smily77/ForEx/README.md

Desktop Widget displaying:
- Time
- Date
- Actual Time of 6 locations
- Foreign Exchange rates for 3 currencies
