smily77/ForEx/STL/DesktopWidget_II_cover.stl

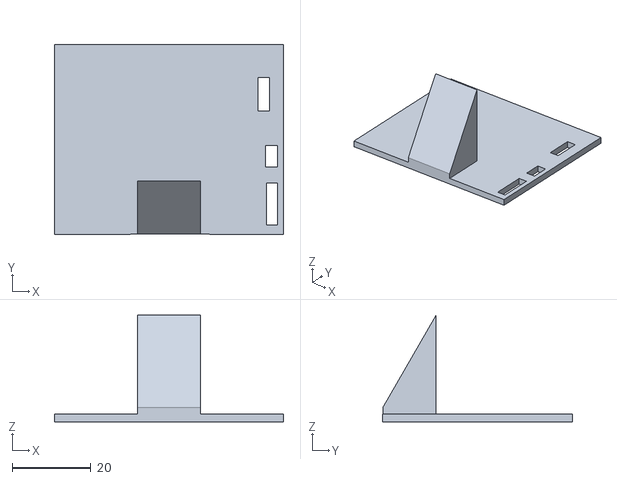
[picture p1: CAD file, 2016-04-16]
STL/DesktopWidget_II_cover.stl
58.0 x 48.0 x 27.0
