smily77/ForEx/STL/DesktopWidget_II_body.stl

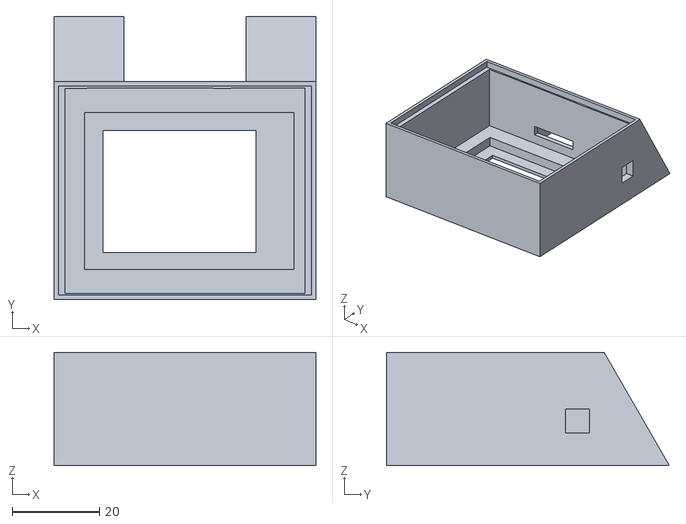
[picture p2: CAD file, 2016-04-16]
STL/DesktopWidget_II_body.stl
60.0 x 64.9 x 26.0
