smily77/ForEx/STL/DesktopWidget_II_knob.stl

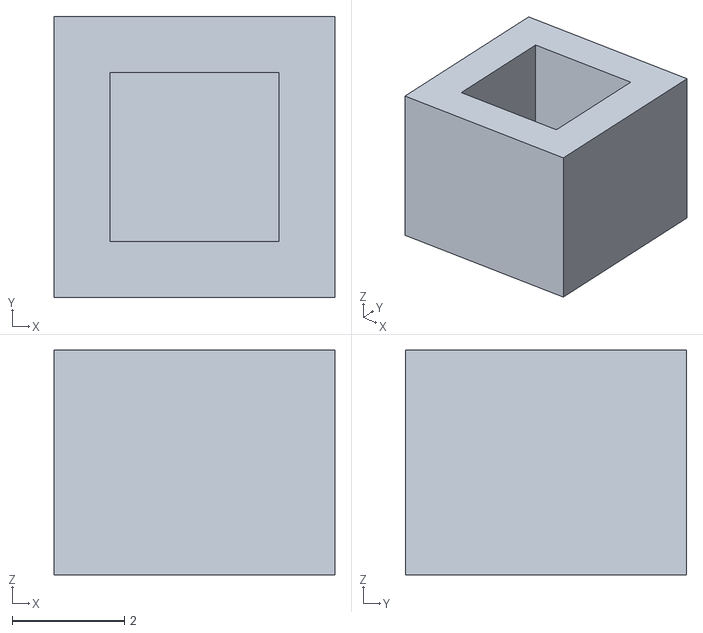
[picture p3: CAD file, 2016-04-16]
STL/DesktopWidget_II_knob.stl
5.00 x 5.00 x 4.00
