smily77/ForEx/Cirquit/Forex_cirquit.pdf

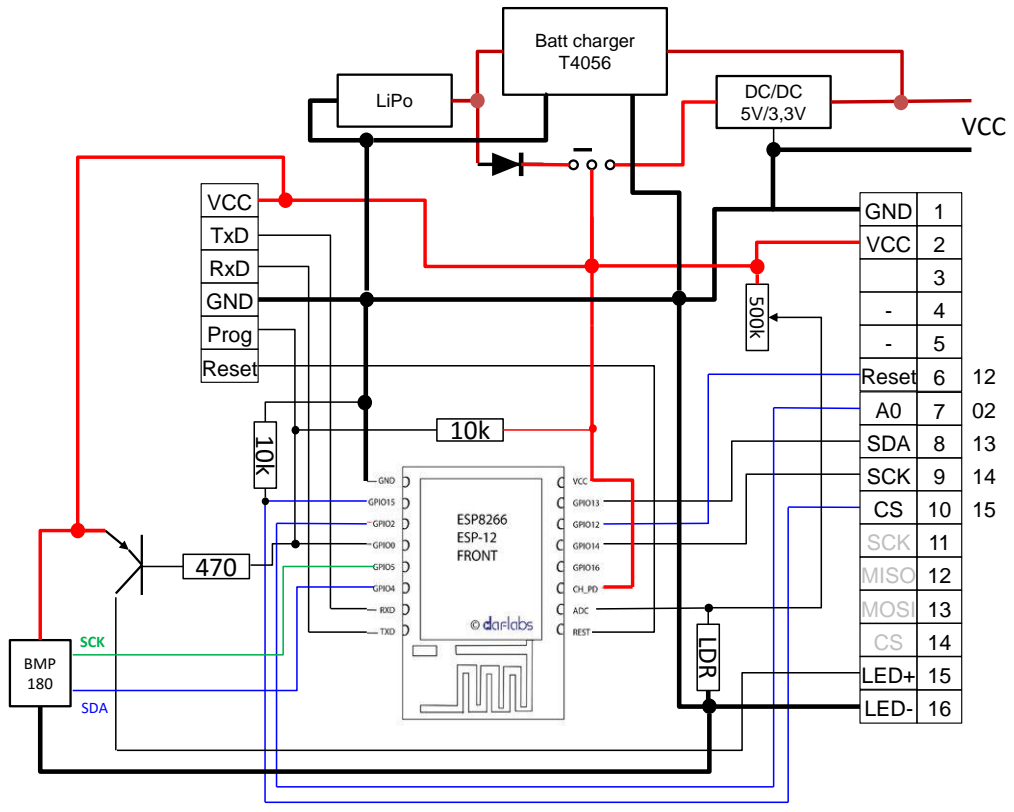
[picture p4: page 1]
VCC; TxD; GND; RxD; Prog; Reset; GND VCC--; SDA; SCK; MISO; MOSI; LED+; LED; LiPo; Batt charger T4056; LDR; BMP 180
