smily77/ForEx/ForEx_2_UART_Frankfurter/X_InternetInfo.ino

// X_InternetInfo.ino – ForEx_2_1_Frankfurter
// Wechselkurse per LTE-Modul BK-7670 abrufen.
//
// ARCHITEKTUR (v2.1-FR-SSL):
//   Statt den eingebauten HTTP/SSL-Stack des BK-7670 zu nutzen (dessen
//   TLS-Fingerprint von Cloudflare blockiert wird), öffnet das Modul nur
//   eine rohe TCP-Verbindung.  BearSSL auf dem ESP8266 übernimmt den
//   TLS-Handshake – mit demselben JA3-Fingerprint wie beim 4G-Modem/WiFi.
//
//   LTEClient  (AT+CIPOPEN, TCP-Transport)
//       ↓
//   ESP_SSLClient  (BearSSL TLS, läuft auf ESP8266)
//       ↓
//   api.frankfurter.app:443  (Cloudflare akzeptiert BearSSL-JA3)
//
// ABHÄNGIGKEIT:
//   Bibliothek "ESP_SSLClient" von mobizt installieren:
//     Arduino IDE: Sketch → Bibliothek einbinden → Bibliotheken verwalten
//                  → "ESP_SSLClient" suchen und installieren
//     PlatformIO:  lib_deps = mobizt/ESP_SSLClient
//
// ESP8266 SDK – CPU-Frequenz umschalten (80 ↔ 160 MHz)
extern "C" {
  #include "user_interface.h"
}

// ============================================================
// LTEClient – Arduino-Client-Adapter für BK-7670 (SIMCom A7670E)
//
// Stellt eine rohe TCP-Verbindung über die AT-Befehle des Moduls her.
// Implementiert das Arduino-Client-Interface, damit ESP_SSLClient
// (BearSSL) darauf aufsetzen kann.
//
// WICHTIG: Alle Methoden die von BearSSL im TLS-Handshake aufgerufen
// werden (write/available/read) verwenden statische char-Puffer statt
// String-Objekte, um Heap-Fragmentierung zu vermeiden.
// BearSSL ruft available() hunderte Male auf – jede String-Allokation
// dort würde den Heap nach wenigen Handshakes zerstören.
//
// AT-Befehlssatz: NETOPEN / CIPOPEN / CIPSEND / CIPRXGET / CIPCLOSE
// Referenz: A76XX Series TCPIP Application Note (SIMCom)
// ============================================================
class LTEClient : public Client {
public:

  // --- Verbindung aufbauen ---
  // KEINE String-Allokation! connect() läuft direkt vor dem TLS-Handshake.
  // Jede String-Allokation hier fragmentiert den Heap und kann dazu führen,
  // dass BearSSL's malloc() NULL zurückgibt → Exception (28).
  int connect(const char *host, uint16_t port) override {
    _connected = false;
    _rxLen = 0;
    _rxPos = 0;
    _lastPoll = 0;

    // Alle AT-Befehle mit statischen Puffern – kein String/Heap
    _sendATraw(F("AT+CIPRXGET=1"), 2000);
    _sendATraw(F("AT+CIPCLOSE=0"), 2000);
    _sendATraw(F("AT+NETCLOSE"), 5000);
    delay(500);

    _sendATraw(F("AT+CSOCKSETPN=1"), 1000);
    _sendATraw(F("AT+CIPMODE=0"), 1000);

    _sendATraw(F("AT+NETOPEN"), 15000);
    delay(1000);

    // TCP-Verbindung öffnen (einziger dynamischer Befehl → _sendATcmd)
    char cmd[80];
    snprintf(cmd, sizeof(cmd),
             "AT+CIPOPEN=0,\"TCP\",\"%s\",%d", host, port);
    _sendATcmd(cmd, 20000, "+CIPOPEN: 0,0");

    if (strstr(_atBuf, "+CIPOPEN: 0,0") != NULL) {
      _connected = true;
      return 1;
    }
    return 0;
  }

  int connect(IPAddress ip, uint16_t port) override {
    char host[16];
    snprintf(host, sizeof(host), "%d.%d.%d.%d", ip[0], ip[1], ip[2], ip[3]);
    return connect(host, port);
  }

  // --- Daten senden ---
  // HOT PATH: wird von BearSSL während TLS-Handshake aufgerufen.
  // Verwendet statische Puffer statt String.
  size_t write(uint8_t b) override { return write(&b, 1); }

  size_t write(const uint8_t *buf, size_t size) override {
    if (!_connected || size == 0) return 0;

    // A7670 CIPSEND max 1460 Bytes pro Aufruf (ein TCP-Segment)
    int toSend = (size > 1024) ? 1024 : (int)size;

    char cmd[32];
    snprintf(cmd, sizeof(cmd), "AT+CIPSEND=0,%d", toSend);

    // AT-Befehl senden, auf ">" Prompt warten
    delay(10);  // 10ms reicht – Modul verarbeitet CIPSEND schnell
    while (lteSerial.available()) lteSerial.read();
    lteSerial.println(cmd);

    bool gotPrompt = false;
    unsigned long t0 = millis();
    while (millis() - t0 < 5000) {
      while (lteSerial.available()) {
        if (lteSerial.read() == '>') { gotPrompt = true; break; }
      }
      if (gotPrompt) break;
      ESP.wdtFeed();
      yield();
    }
    if (!gotPrompt) { _connected = false; return 0; }

    // Restliche Zeichen nach ">" konsumieren
    delay(10);
    while (lteSerial.available()) lteSerial.read();

    // Binärdaten senden als Block-Write.
    lteSerial.write(buf, toSend);

    // +CIPSEND Bestätigung abwarten – statischer Puffer statt String
    int rLen = 0;
    t0 = millis();
    while (millis() - t0 < 10000 && rLen < (int)sizeof(_atBuf) - 1) {
      while (lteSerial.available() && rLen < (int)sizeof(_atBuf) - 1) {
        _atBuf[rLen++] = (char)lteSerial.read();
      }
      _atBuf[rLen] = '\0';
      if (strstr(_atBuf, "+CIPSEND:") != NULL) break;
      if (strstr(_atBuf, "ERROR") != NULL) { _connected = false; return 0; }
      ESP.wdtFeed();
      yield();
    }
    return toSend;
  }

  // --- Daten empfangen ---
  // HOT PATH: BearSSL pollt available() intensiv während TLS.
  // Komplett ohne String/Heap-Allokation implementiert.
  int available() override {
    if (_rxPos < _rxLen) return _rxLen - _rxPos;

    // Modul nicht öfter als alle 20 ms abfragen (BearSSL pollt intensiv).
    // 20ms statt 50ms: schnellere Handshake-Antwortzeiten, bei 19200 Baud
    // ist eine AT-Antwort (~30 Bytes) in ~15ms komplett übertragen.
    unsigned long now = millis();
    if (now - _lastPoll < 20) return 0;
    _lastPoll = now;

    // Modul nach gepufferten Bytes fragen – statischer Puffer
    _sendATraw(F("AT+CIPRXGET=4,0"), 1000);

    char* idx = strstr(_atBuf, "+CIPRXGET: 4,0,");
    if (idx) {
      int avail = atoi(idx + 15);
      if (avail > 0) {
        _pullFromModule(avail);
        return _rxLen - _rxPos;
      }
    }
    return 0;
  }

  int read() override {
    uint8_t b;
    if (read(&b, 1) == 1) return b;
    return -1;
  }

  // HOT PATH: Verwendet statischen Puffer für AT-Abfrage
  int read(uint8_t *buf, size_t size) override {
    // Aus lokalem Puffer bedienen
    if (_rxPos < _rxLen) {
      int avail = _rxLen - _rxPos;
      int n = ((int)size < avail) ? (int)size : avail;
      memcpy(buf, _rxBuf + _rxPos, n);
      _rxPos += n;
      return n;
    }

    // Puffer leer → vom Modul nachladen (statischer Puffer)
    _sendATraw(F("AT+CIPRXGET=4,0"), 1000);

    char* idx = strstr(_atBuf, "+CIPRXGET: 4,0,");
    if (!idx) return 0;
    int moduleAvail = atoi(idx + 15);
    if (moduleAvail <= 0) return 0;

    _pullFromModule(moduleAvail);

    if (_rxLen <= 0) return 0;
    int n = ((int)size < _rxLen) ? (int)size : _rxLen;
    memcpy(buf, _rxBuf, n);
    _rxPos = n;
    return n;
  }

  int peek() override {
    if (_rxPos < _rxLen) return _rxBuf[_rxPos];
    return -1;
  }

  void flush() override { }

  void stop() override {
    _sendATraw(F("AT+CIPCLOSE=0"), 5000);
    delay(500);
    _sendATraw(F("AT+NETCLOSE"), 5000);
    _connected = false;
    _rxLen = 0;
    _rxPos = 0;
  }

  uint8_t connected() override { return _connected ? 1 : 0; }
  operator bool() override { return _connected; }

private:
  bool _connected = false;
  static uint8_t _rxBuf[256];   // Statischer Empfangspuffer (spart Stack)
  int _rxLen = 0;               // Gültige Bytes im Puffer
  int _rxPos = 0;               // Aktuelle Leseposition
  unsigned long _lastPoll = 0;  // Letzte Modul-Abfrage (Throttle)

  // Statischer AT-Antwortpuffer – wird von allen Methoden geteilt.
  // 128 Bytes: genug für CIPOPEN-Echo (~55 Bytes) + Antwort.
  // Kein Reentrancy-Problem da ESP8266 single-threaded ist.
  static char _atBuf[128];

  // AT-Befehl senden (F-String) und Antwort in _atBuf lesen.
  // Wartet auf "OK" oder "ERROR". KEINE Heap-Allokation.
  void _sendATraw(const __FlashStringHelper* cmd, unsigned long timeout) {
    int len = 0;
    delay(10);
    while (lteSerial.available()) lteSerial.read();
    lteSerial.println(cmd);

    unsigned long t0 = millis();
    while (millis() - t0 < timeout && len < (int)sizeof(_atBuf) - 1) {
      while (lteSerial.available() && len < (int)sizeof(_atBuf) - 1) {
        _atBuf[len++] = (char)lteSerial.read();
      }
      _atBuf[len] = '\0';
      if (strstr(_atBuf, "OK\r") || strstr(_atBuf, "ERROR")) break;
      ESP.wdtFeed();
      yield();
    }
    _atBuf[len] = '\0';
  }

  // AT-Befehl senden (C-String) mit optionalem waitFor-Keyword.
  // Für connect()/stop() – dynamische Befehle wie AT+CIPOPEN.
  void _sendATcmd(const char* cmd, unsigned long timeout, const char* waitFor = nullptr) {
    int len = 0;
    delay(10);
    while (lteSerial.available()) lteSerial.read();
    lteSerial.println(cmd);

    unsigned long t0 = millis();
    while (millis() - t0 < timeout && len < (int)sizeof(_atBuf) - 1) {
      while (lteSerial.available() && len < (int)sizeof(_atBuf) - 1) {
        _atBuf[len++] = (char)lteSerial.read();
      }
      _atBuf[len] = '\0';
      if (waitFor) {
        if (strstr(_atBuf, waitFor)) break;
      } else {
        if (strstr(_atBuf, "OK\r")) break;
      }
      if (strstr(_atBuf, "ERROR")) break;
      ESP.wdtFeed();
      yield();
    }
    _atBuf[len] = '\0';
  }

  // Daten vom Modul in den lokalen Puffer lesen.
  // AT+CIPRXGET=2,0,<len> → +CIPRXGET: 2,0,<actual>,<remaining>\r\n<Daten>\r\nOK
  // Verwendet statischen Header-Puffer statt String.
  void _pullFromModule(int moduleAvail) {
    _rxLen = 0;
    _rxPos = 0;

    int toRead = moduleAvail;
    if (toRead > (int)sizeof(_rxBuf)) toRead = (int)sizeof(_rxBuf);

    char cmd[32];
    snprintf(cmd, sizeof(cmd), "AT+CIPRXGET=2,0,%d", toRead);

    delay(10);  // 10ms reicht für CIPRXGET=2 (statt 30ms)
    while (lteSerial.available()) lteSerial.read();
    lteSerial.println(cmd);

    // Header lesen: +CIPRXGET: 2,0,<actual>,<remaining>\r\n
    // Statischer Puffer statt String – kein Heap-Allokation
    static char hdr[80];
    int hdrLen = 0;
    bool gotHeader = false;
    unsigned long t0 = millis();
    while (millis() - t0 < 5000 && hdrLen < (int)sizeof(hdr) - 1) {
      while (lteSerial.available() && hdrLen < (int)sizeof(hdr) - 1) {
        char c = (char)lteSerial.read();
        hdr[hdrLen++] = c;
        hdr[hdrLen] = '\0';
        if (c == '\n' && strstr(hdr, "+CIPRXGET: 2") != NULL) {
          gotHeader = true;
          break;
        }
      }
      if (gotHeader) break;
      ESP.wdtFeed();
      yield();
    }
    if (!gotHeader) return;

    // Tatsächliche Datenlänge parsen
    char* idx = strstr(hdr, "+CIPRXGET: 2,0,");
    if (!idx) return;
    int actual = atoi(idx + 15);
    if (actual <= 0) return;
    if (actual > (int)sizeof(_rxBuf)) actual = sizeof(_rxBuf);

    // Exakt 'actual' Bytes Binärdaten lesen
    t0 = millis();
    while (_rxLen < actual && millis() - t0 < 5000) {
      while (lteSerial.available() && _rxLen < actual) {
        _rxBuf[_rxLen++] = lteSerial.read();
      }
      if (_rxLen >= actual) break;
      ESP.wdtFeed();
      yield();
    }

    // Trailing \r\nOK\r\n konsumieren (6 Bytes ≈ 3ms bei 19200 Baud)
    delay(20);
    while (lteSerial.available()) lteSerial.read();
  }
};

// Statische Member-Definitionen
uint8_t LTEClient::_rxBuf[256];
char    LTEClient::_atBuf[128];

// ============================================================
// WECHSELKURSE ABRUFEN
// ============================================================

void catchCurrencies() {
  const char* httpHost = "api.frankfurter.app";
  const char* httpPath = "/latest?from=EUR&to=CHF,USD,GBP";


  // Watchdog-Zähler zurücksetzen (180s Timeout reicht für TLS)
  watchDogCount = 0;

  // CPU auf 160 MHz hochschalten – halbiert BearSSL-Crypto-Dauer.
  // Weniger CPU-Zeit in Bignum-Loops reduziert TLS-Latenz.
  system_update_cpu_freq(160);

  // Heap-Guard: BearSSL braucht ~12 KB für TLS-Handshake bei ECDHE
  // (SSL-Kontext ~4 KB + IO-Puffer 2.5 KB + ECDHE-Workspace ~2 KB + Cert ~3 KB)
  // Crash bei 15568 war wegen Heap-FRAGMENTIERUNG (String), nicht Gesamtmenge.
  // Jetzt ohne Strings → unfragmentierter Heap → 18 KB reichen sicher.
  if (ESP.getFreeHeap() < 18000) {
    tft.setTextColor(ST7735_YELLOW);
    tft.println("Heap zu niedrig");
    tft.setTextColor(ST7735_WHITE);
    system_update_cpu_freq(80);
    return;
  }

  // Statischer Puffer für HTTP-Antwort (frankfurter.app: ~120 Bytes)
  static char body[512];
  int bodyLen = 0;
  memset(body, 0, sizeof(body));
  bool success = false;

  // --- TCP-Verbindung über LTEClient öffnen ---
  static LTEClient lteClient;  // static: nicht auf dem Stack (spart ~50 Bytes)


  if (!lteClient.connect(httpHost, 443)) {
    tft.setTextColor(ST7735_YELLOW);
    tft.println("TCP Fehler");
    tft.setTextColor(ST7735_WHITE);
    lteClient.stop();
    system_update_cpu_freq(80);
    return;
  }

  // --- BearSSL-TLS über die TCP-Verbindung ---
  // Static: vermeidet wiederholte Konstruktion/Destruktion und Heap-Churn.
  // BearSSL-Kontextstrukturen bleiben allokiert statt bei jedem Abruf
  // neu angelegt und freigegeben zu werden (reduziert Fragmentierung).
  static ESP_SSLClient sslClient;
  sslClient.setInsecure();             // Zertifikat nicht prüfen (spart RAM)
  sslClient.setBufferSizes(2048, 512); // RX 2 KB (statt 4 KB – spart Heap)
  sslClient.setClient(&lteClient);


  if (!sslClient.connect(httpHost, 443)) {
    tft.setTextColor(ST7735_YELLOW);
    tft.println("TLS Fehler");
    tft.setTextColor(ST7735_WHITE);
    sslClient.stop();
    lteClient.stop();  // Auch TCP sauber schliessen (Modul-State aufräumen)
    system_update_cpu_freq(80);
    return;
  }

  // --- HTTP GET Request senden ---
  sslClient.print(F("GET "));
  sslClient.print(httpPath);
  sslClient.println(F(" HTTP/1.1"));
  sslClient.print(F("Host: "));
  sslClient.println(httpHost);
  sslClient.println(F("Accept: application/json"));
  sslClient.println(F("Connection: close"));
  sslClient.print("\r\n");

  // --- HTTP-Header überspringen (bis \r\n\r\n) ---
  int nlCount = 0;
  bool headersDone = false;
  unsigned long t0 = millis();

  while (sslClient.connected() && millis() - t0 < 30000) {
    if (sslClient.available()) {
      char c = sslClient.read();
      if (c == '\r') continue;
      if (c == '\n') {
        nlCount++;
        if (nlCount >= 2) { headersDone = true; break; }
      } else {
        nlCount = 0;
      }
    }
    ESP.wdtFeed();
    yield();
  }

  // --- HTTP-Body lesen ---
  if (headersDone) {
    t0 = millis();
    while (sslClient.connected() && millis() - t0 < 15000) {
      while (sslClient.available() && bodyLen < (int)(sizeof(body) - 1)) {
        body[bodyLen++] = sslClient.read();
      }
      if (!sslClient.available() && bodyLen > 0) {
        // Kurz warten ob noch Daten kommen
        delay(200);
        if (!sslClient.available()) break;
      }
      ESP.wdtFeed();
      yield();
    }
    body[bodyLen] = '\0';
    success = (bodyLen >= 10);
  }

  sslClient.stop();


  if (!success) {
    tft.setTextColor(ST7735_YELLOW);
    tft.println("Kurs-Fehler");
    tft.setTextColor(ST7735_WHITE);
    return;
  }

  // -------------------------------------------------------
  // JSON parsen mit strstr/atof – kein String-Objekt nötig.
  // fxSym[0]="CHF", fxSym[1]="USD", fxSym[2]="EUR", fxSym[3]="GBP"
  // API liefert CHF, USD, GBP relativ zu EUR.
  // EUR selbst nicht in Antwort → 1.0 gesetzt.
  // -------------------------------------------------------
  for (int i = 0; i < 4; i++) {
    if (fxSym[i] != "EUR") {
      char key[10];
      snprintf(key, sizeof(key), "\"%s\":", fxSym[i].c_str());
      char* p = strstr(body, key);
      if (p) {
        p += strlen(key);
        fxValue[i] = atof(p);
      } else {
        fxValue[i] = 0.0;
      }
    } else {
      fxValue[i] = 1.0;
    }

  }

  // Umrechnung: CHF/Währung = CHF/EUR ÷ Währung/EUR
  for (int l = 1; l < 4; l++) {
    if (fxValue[l] > 0.0) {
      fxValue[l] = fxValue[0] / fxValue[l];
    }
    if (firstRun) {
      tft.print(fxSym[l]);
      tft.print(": ");
      tft.println(fxValue[l]);
    }
  }

  // CPU zurück auf 80 MHz (Stromsparen im Normalbetrieb)
  system_update_cpu_freq(80);

}
