smily77/ForEx/(commit log)

2016-05-01 Added files via upload
    Bug fix - anaglogRead
    [ForEx_1_0.ino]
2026-03-05 Add ForEx_2_1: GSM/LTE module (BK-7670) replaces WiFi + BMP180
    - SoftwareSerial UART on GPIO4/GPIO5 (19200 baud) to BK-7670
    - Time from GSM operator via NITZ/AT+CCLK? (zero data usage)
    - HTTP currency fetch via AT+HTTPINIT/HTTPACTION (LTE data)
    - Daily update at 17:00 instead of midnight
    - Configurable provider constant: M-Budget Mobile or Digital Republic
    - Mermaid wiring schema saved in ForEx_2_1/schema.md
    https://claude.ai/code/session_01CxpABZzcaZkYPwWLwvDzsF
    [AirportDatabase.h, ForEx_2_1.ino, X_InternetInfo.ino, x_printsubs.ino, x_subroutines.ino]
2026-03-05 Fix forward declarations for sendAT/sendATwait in X_InternetInfo.ino
    Arduino IDE merges .ino files alphabetically; uppercase X_ is processed
    before lowercase x_subroutines.ino, causing 'not declared in this scope'
    errors. Added explicit forward declarations at the top of the file.
    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
    [X_InternetInfo.ino]
2026-03-05 Fix duplicate default arguments in forward declarations
    C++ forbids specifying default arguments in both declaration and
    definition. Removed defaults from forward decls in X_InternetInfo.ino;
    they remain in the definitions in x_subroutines.ino.
    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
    [X_InternetInfo.ino]
2026-03-05 Fix HTTP request: add SAPBR bearer setup before HTTPINIT
    AT+HTTPPARA="CID",1 returned ERROR because no bearer profile was open.
    SIM800-compatible modules require SAPBR=1,1 (open bearer) before the
    HTTP stack can be bound to a context via CID. Added SAPBR setup sequence
    before HTTPINIT and SAPBR teardown at all exit points.
    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
    [X_InternetInfo.ino]
2026-03-05 Fix HTTP flow, set provider 1, disable brightness in debug
    - Remove SAPBR commands (BK-7670 does not support them)
    - Remove AT+HTTPPARA="CID" (not supported, module uses active PDP context automatically)
    - Fix URL command: use snprintf/char buffer instead of String concatenation
    to avoid heap fragmentation on ESP8266 causing corrupt AT commands
    - Remove USERDATA header command (reduces memory pressure)
    - Set ACTIVE_PROVIDER to 1 (Digital Republic / Salt, APN "internet")
    - Disable A0 brightness control in loop() when DEBUG is true
    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
    [ForEx_2_1.ino, X_InternetInfo.ino]
2026-03-06 Fix stability: watchdog ISR, yield() in AT loops, switch to HTTPS
    Watchdog ISR (ForEx_2_1.ino):
    - ISR now only sets watchDogTriggered flag instead of calling watchDogAction()
    directly; complex operations (delay, TFT, ESP.reset) are forbidden in ISR
    context on ESP8266 and caused random crashes
    - watchDogAction() is now called from loop() in main context
    - Added watchDogTriggered flag reset in watchDogFeed()
    ESP8266 internal software watchdog (x_subroutines.ino):
    - Added yield() in sendAT and sendATwait busy-wait loops
    - Without yield(), loops longer than ~3s trigger the internal WDT
    (sendATwait with 15s timeout was a guaranteed crash)
    HTTPS + ticker pause during HTTP (X_InternetInfo.i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
    [ForEx_2_1.ino, X_InternetInfo.ino, x_subroutines.ino]
2026-03-06 Fix URL truncation and HTTPSSL: direct lteSerial print, add settle delay
    Root causes:
    - AT+HTTPSSL=1 not supported by BK-7670 (returned ERROR) - removed.
    Modern LTE modules auto-detect https:// from the URL scheme.
    - URL was truncated: String(urlCmd) on fragmented ESP8266 heap caused
    the 87-char AT command string to be corrupted/truncated. Fixed by
    sending URL directly via lteSerial.print() in parts (no String object).
    F() macro keeps literals in PROGMEM, saving RAM further.
    - Added delay(30) before buffer flush in sendAT/sendATwait so that
    any trailing bytes from the previous response are fully received
    before the next command is sent.
    https://claude.ai/code/session_01CxpABZzca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
    [X_InternetInfo.ino, x_subroutines.ino]
2026-03-06 Fix HTTPACTION: wait for complete URC line before checking status
    sendATwait returned as soon as "+HTTPACTION:" appeared mid-stream,
    before the status code and length (,200,123) arrived. The follow-up
    while loop also broke immediately since the partial string was already
    in resp.
    Fix: use sendAT for the command acknowledgment, then wait explicitly
    for the complete URC line by checking for two commas and a newline
    after "+HTTPACTION:". Timeout extended to 30s for SSL handshake.
    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
    [X_InternetInfo.ino]
2026-03-06 Add User-Agent header, read error body for diagnosis, fix HTTPREAD heap
    - Add AT+HTTPPARA="USERDATA" with User-Agent before GET request.
    Many servers (including Cloudflare) return 403 for requests without
    a User-Agent header. Sent via direct lteSerial.println to avoid heap.
    - On non-200 response: read and print response body in DEBUG mode so
    we can see exactly what the server returns (e.g. Cloudflare 403 msg).
    - Fix AT+HTTPREAD: use lteSerial.print(F(...)) + println(httpLen)
    instead of String("AT+HTTPREAD=0,") + String(httpLen) concatenation
    which causes heap fragmentation on the ESP8266.
    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
    [X_InternetInfo.ino]
2026-03-06 Switch from Frankfurter to vatcomply API to bypass Cloudflare 403
    api.frankfurter.app sits behind Cloudflare, which blocks LTE modules
    because their TLS fingerprint (simple SSL stack) matches known bot
    patterns. No header trick (User-Agent etc.) can bypass this.
    api.vatcomply.com uses the same JSON response format and supports the
    same ?base=EUR&symbols=CHF,USD,GBP filtering, so no parser changes
    are needed.
    Also removes the USERDATA/User-Agent block added in the previous commit:
    it was unreliable (SoftwareSerial RX interrupt corrupts the Serial debug
    output during lteSerial TX, making the response unreadable) and is not
    needed against a non-Cloudflare host.
    https://claude.ai/code/session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
2026-03-06 Fix URL command corruption via SoftwareSerial RX interrupt disable during TX
    On ESP8266, SoftwareSerial TX is not interrupt-safe: the RX ISR fires
    between outgoing TX bits and displaces the bit timing, corrupting bytes
    from ~position 76 onward (i.e. the GBP part of the URL). This caused
    the module to receive a garbled URL and return internal error 715.
    Two changes combined:
    1. Build the complete AT+HTTPPARA URL command in a 100-byte char[] with
    snprintf() and send it as a single println() call instead of three
    separate print() calls. Eliminates timing gaps between parts.
    2. Wrap the println() with lteSerial.enableRx(false/true) to suppress
    the SoftwareSerial RX ISR during the entir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
    [X_InternetInfo.ino]
2026-03-06 Switch to exchangerate-api.com (Fastly CDN) to fix TLS 715 error
    vatcomply.com returned +HTTPACTION: 0,715,0 — an internal module error
    indicating TLS handshake failure. The module's SSL stack (likely TLS 1.2
    only) is incompatible with vatcomply.com's server configuration.
    api.exchangerate-api.com runs on Fastly CDN which supports broad TLS
    1.2 compatibility and does not apply Cloudflare-style bot fingerprinting.
    Free endpoint, no API key required.
    The response includes all ~160 currencies in alphabetical order; USD
    appears at ~1700 bytes. Changes:
    - httpLen cap raised from 1024 to 2500 bytes
    - body.reserve(httpLen+20) added to pre-allocate heap and avoid repeated
    String reallocations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
    [X_InternetInfo.ino]
2026-03-06 Fix HTTPREAD body reading: skip initial OK\r before +HTTPREAD: header
    The module sends two separate response frames for AT+HTTPREAD:
    1. \r\nOK\r\n ← command acknowledgment (immediate)
    2. +HTTPREAD: <len>\r\n ← data header + JSON + final OK\r\n
    The previous loop broke on the first "OK\r" (frame 1), storing only
    that acknowledgment in body. The 2500-byte JSON arrived afterwards
    and was swallowed by the AT+HTTPTERM response collector.
    Fix: track whether "+HTTPREAD:" has appeared in the buffer. Only break
    on "OK\r" after that header has been seen. This ensures the loop waits
    for the final OK that follows the actual data, not the command ACK.
    Same fix applied to the error-body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
    [X_InternetInfo.ino]
2026-03-06 Switch to v6 API with CHF as base currency
    - Host: open.er-api.com, path: /v6/latest/CHF
    - v6 is the current LTS endpoint; no API key required
    - Using CHF as base eliminates the EUR pivot calculation:
    rates["USD"/"EUR"/"GBP"] now give X-per-CHF directly,
    inversion (fxValue[0]/fxValue[l]) gives CHF-per-X unchanged
    - Removed EUR=1.0 hard-code; CHF=1.0 now parsed from JSON like
    any other symbol (rates["CHF"] is always 1 in a CHF-base response)
    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
2026-03-06 Revert to v4 EUR-base API (TLS 715 error on open.er-api.com)
    BK-7670 rejects open.er-api.com TLS certificate (error 715).
    Back to api.exchangerate-api.com/v4/latest/EUR which works reliably.
    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
    [X_InternetInfo.ino]
2026-03-07 ForEx_2_1_Frankfurter: fix USERDATA TX corruption + fuller User-Agent
    Two issues addressed:
    1. USERDATA command is >76 chars → apply same RX-ISR disable pattern
    as the URL command to prevent SoftwareSerial byte-timing corruption
    2. Cloudflare rejects bare "Mozilla/5.0"; switch to full Chrome/120 UA
    with Accept-Language header for more convincing browser fingerprint
    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
    [X_InternetInfo.ino]
2026-03-07 ForEx_2_1_Frankfurter: ACTIVE_PROVIDER=0, revert USERDATA to simple call
    - Switch provider to M-Budget Mobile (Swisscom APN)
    - Revert USERDATA block to simple sendAT() – ISR-disable complexity
    brought no benefit since Cloudflare blocks on IP level regardless
    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
    [ForEx_2_1_Frankfurter.ino, X_InternetInfo.ino]
2026-03-07 ForEx_2_1: fix heap-fragmentation crash + ACTIVE_PROVIDER=0
    Root cause: String body with reserve(2500) fails silently after hours
    of operation when heap is fragmented. Each body += char then causes
    thousands of small reallocations → ESP8266 crash.
    Fix:
    - Replace String body with static char body[2600] (BSS segment,
    never allocated on heap, no fragmentation)
    - Replace body.indexOf/substring with strstr/atof (no temp Strings)
    - Extend HTTPREAD timeout 12s → 20s for slow SSL connections
    - Add ESP.getFreeHeap() debug output at entry for future diagnostics
    - ACTIVE_PROVIDER 1 → 0 (M-Budget Mobile / Swisscom)
    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
    [ForEx_2_1.ino, X_InternetInfo.ino]
2026-03-07 SIM-PIN-Unterstützung via Credentials.h (ForEx_2_1 + Frankfurter)
    - Credentials.h zu .gitignore hinzugefügt (PIN bleibt lokal, nie auf GitHub)
    - Credentials.h in beiden Projekten erstellt (GPSII_PIN = "")
    - #include "Credentials.h" in beide Hauptdateien eingefügt
    - initLTE(): AT+CPIN-Logik erweitert – bei "SIM PIN" und ACTIVE_PROVIDER==0
    wird GPSII_PIN automatisch gesendet; falscher PIN → initLTE() false
    - Kein PIN-Code kompiliert wenn ACTIVE_PROVIDER != 0 (#if-Präprozessor)
    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
2026-03-07 Fix ESP8266-Abstürze während HTTPACTION-Warten (beide Programme)
    Root cause: Der HTTPACTION-Wait-Loop verwendete `resp +=` (String, byte-by-byte)
    → bei jedem Capacity-Überschreiten ein realloc() auf dem Heap, genau dann wenn
    das LTE-Modul asynchron Bytes sendet. Zusätzlich war der SoftwareSerial-Puffer
    nur 64 Bytes – bei mehreren gleichzeitigen URCs lief er über.
    Fixes:
    - HTTPACTION-Wait-Loop: String → static char urcBuf[128] + strstr/strchr
    → kein realloc(), kein Heap-Stress im kritischen Wartebereich
    - ESP.wdtFeed() explizit im Wait-Loop (Hardware-WDT sicher gefüttert)
    - delay(200) → delay(100) für schnellere URC-Erkennung
    - Timeout 30s → 35s (mehr Spielraum bei langs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
    [ForEx_2_1.ino, ForEx_2_1_Frankfurter.ino, X_InternetInfo.ino]
2026-03-07 Fix: SoftwareSerial-Puffergrösse über begin() statt Konstruktor
    ESP8266 Core 3.1.2 (EspSoftwareSerial 6.x) hat den Puffer-Parameter
    im Konstruktor entfernt. Puffergrösse wird jetzt in begin() gesetzt:
    lteSerial.begin(LTE_BAUD, SWSERIAL_8N1, RX, TX, false, 256)
    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
    [ForEx_2_1.ino, ForEx_2_1_Frankfurter.ino]
2026-03-07 TIMINGDEBUG-Flag + HTTPREAD-Timeout 30s (beide Programme)
    - TIMINGDEBUG true: Kursabruf alle 30 Minuten (für Testzwecke)
    - TIMINGDEBUG false: normaler Betrieb, täglich um 17:00 Uhr
    - HTTPREAD-Timeout erhöht: 20s → 30s (ForEx_2_1), 15s → 30s (Frankfurter)
    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
2026-03-07 Fix Cloudflare 403: Fallback-API + verbesserte HTTP-Header
    Cloudflare blockiert den BK-7670 per TLS-Fingerprinting (JA3) –
    HTTP-Header allein können das nicht umgehen. Lösung:
    - Primär: frankfurter.app mit vollem Browser-UA + Host-Header versuchen
    - Fallback: automatisch auf exchangerate-api.com (Fastly CDN) umschalten
    - RX-ISR-Schutz auch für den langen USERDATA-Befehl (>76 Bytes)
    - Body-Puffer auf 2600 Bytes vergrössert (für die grössere Fallback-Antwort)
    - Redirect-Following (AT+HTTPPARA="REDIR") aktiviert
    - Beide APIs nutzen dasselbe JSON-Format → gleicher Parser
    https://claude.ai/code/session_01NkDZa3kQGJNAKdDhMDBCeb
    [X_InternetInfo.ino]
2026-03-07 TCP+BearSSL: TLS auf ESP8266 statt im BK-7670
    Cloudflare blockiert den TLS-Fingerprint (JA3) des BK-7670-Moduls.
    Lösung: Das Modul öffnet nur eine rohe TCP-Verbindung (AT+CIPOPEN),
    der TLS-Handshake läuft auf dem ESP8266 via BearSSL – gleicher
    JA3-Fingerprint wie beim funktionierenden 4G-Modem/WiFi-Setup.
    Neue Komponenten:
    - LTEClient: Arduino-Client-Adapter über AT+NETOPEN/CIPOPEN/CIPSEND/CIPRXGET
    - ESP_SSLClient (mobizt): universelle BearSSL-TLS-Schicht über LTEClient
    - Kompakte frankfurter.app-Antwort (~120 Bytes) statt Fallback (~2500 Bytes)
    Vorteile gegenüber dem HTTP-Stack-Ansatz:
    - Kein Cloudflare-Block (BearSSL-JA3 wird akzeptiert)
    - ~120 Bytes Datenvolumen pro Abruf (statt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
2026-03-07 Fix ESP_SSLClient::println() compile error - use print("\r\n") instead
    ESP_SSLClient's println() requires an argument unlike the standard
    Arduino Client. Replace the empty println() with print("\r\n") to
    terminate the HTTP headers.
    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
    [X_InternetInfo.ino]
2026-03-07 Fix WDT crash: static buffers, String.reserve(), wdtFeed in all loops
    - Make LTEClient instance static (off the stack)
    - Make _rxBuf static and reduce from 512 to 256 bytes (saves stack)
    - Add String.reserve() in sendAT/sendATwait/_pullFromModule/write
    to prevent heap fragmentation from char-by-char append
    - Add ESP.wdtFeed() in all busy-wait loops to prevent HW watchdog
    reset during long AT operations (NETOPEN takes up to 15s)
    - Add heap debug print before TCP connect
    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
    [X_InternetInfo.ino, x_subroutines.ino]
2026-03-07 Fix CIPOPEN match: wait for full response "+CIPOPEN: 0,0"
    sendATwait was matching "+CIPOPEN:" too early (before the result
    code "0,0" arrived from the modem), causing connect() to always
    fail. Now waits for the complete "+CIPOPEN: 0,0" success string.
    Also simplified NETOPEN handling - wait for OK + delay instead of
    parsing the asynchronous +NETOPEN result code.
    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
    [X_InternetInfo.ino]
2026-03-07 Hide SIM PIN from serial debug output
    Send AT+CPIN command directly instead of through sendAT() to
    prevent the PIN from appearing in plaintext on the serial monitor.
    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
    [x_subroutines.ino]
2026-03-07 Robustness improvements for both ForEx_2_1 and Frankfurter
    Changes applied to both versions:
    #1+#2 Watchdog: 180s timeout, feed only on minute change (not every
    loop iteration), no longer detached during HTTP/TLS - catches frozen
    states and hangs during currency fetch.
    #6 Retry: If currency fetch fails (fxValue[0] <= 0), retry after 30s.
    #7 Keep old values: Don't overwrite fxValue with 0.0 when a currency
    is missing from the API response - keep the previous valid value.
    #9 TFT flicker: Replace fillScreen with targeted fillRect per section,
    reducing visible flash during minute updates.
    #10 snprintf: Replace sprintf with snprintf in displayMainScreen to
    prevent potential buffer overflow i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
    [ForEx_2_1.ino, ForEx_2_1_Frankfurter.ino, X_InternetInfo.ino, x_printsubs.ino, x_subroutines.ino]
2026-03-07 fix: show 0 instead of stale value when currency not found in API response
    Both ForEx_2_1 and ForEx_2_1_Frankfurter now set fxValue[i] = 0.0 when
    a currency key is missing from the JSON response, ensuring no outdated
    (potentially wrong) rates are displayed.
    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
    [X_InternetInfo.ino]
2026-03-09 fix: eliminate heap fragmentation and crash causes in Frankfurter variant
    Root cause of persistent crashes: BearSSL calls available()/read()/write()
    hundreds of times during TLS handshake. Each call went through sendAT()
    which allocated/freed String objects, fragmenting ESP8266's ~40KB heap
    until malloc fails.
    Changes:
    - LTEClient hot-path methods (available/read/write/_pullFromModule) now
    use static char buffers instead of String/sendAT — zero heap allocation
    during TLS handshake
    - Add _sendATraw() helper with static _atBuf[96] for AT commands
    - Reduce SSL RX buffer from 4096 to 2048 bytes (saves ~2KB heap)
    - Make ESP_SSLClient static to avoid repeated construct/destruct heap churn
    -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
    [ForEx_2_1_Frankfurter.ino, X_InternetInfo.ino]
2026-03-09 fix: address TLS handshake failures from SoftwareSerial timing corruption
    The previous commit fixed heap fragmentation but TLS still fails because
    BearSSL's CPU-intensive crypto (RSA/ECDHE bignum loops) disrupts
    SoftwareSerial's ISR bit-sampling timing, corrupting AT responses.
    Three root causes addressed:
    1. WiFi firmware runs by default on ESP8266 even when unused
    - Its background ISRs compete with SoftwareSerial for interrupt time
    - WiFi.mode(WIFI_OFF) + forceSleepBegin() frees ~20KB heap and
    eliminates all WiFi-related interrupt interference
    2. CPU at 80MHz makes BearSSL crypto too slow
    - system_update_cpu_freq(160) before TLS, back to 80 after
    - Halves crypto duratio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
    [ForEx_2_1_Frankfurter.ino, X_InternetInfo.ino]
2026-03-09 fix: eliminate ALL String heap allocation before TLS handshake
    Crash analysis: Exception (28) at epc1=0x4000e1f0 with only 15568 bytes
    free heap. BearSSL's internal malloc() returned NULL → null pointer
    dereference → LoadProhibited exception.
    Root cause: connect() still used sendAT()/sendATwait() which allocate
    String objects on the heap. These get freed before TLS starts, but leave
    fragmentation holes that prevent BearSSL from allocating contiguous blocks.
    - Rewrite connect() to use _sendATraw(F()) for all fixed AT commands
    and new _sendATcmd(char*) for dynamic CIPOPEN command
    - Rewrite stop() to use _sendATraw(F()) instead of sendAT(String)
    - Add _sendATcmd() method: like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
    [X_InternetInfo.ino]
2026-03-09 fix: lower heap guard from 22000 to 18000 (unfragmented heap is sufficient)
    21824 bytes free heap was blocked by 22000 guard. The previous crash at
    15568 bytes was caused by heap FRAGMENTATION from String allocations,
    not insufficient total heap. Now that LTEClient uses zero heap allocation,
    the heap is unfragmented and BearSSL needs ~12KB for ECDHE handshake:
    4KB engine + 2.5KB IO buffers + 2KB ECDHE + 3KB cert = ~12KB
    18000 guard gives ~6KB safety margin above BearSSL's actual needs.
    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
    [X_InternetInfo.ino]
2026-03-17 Add ForEx_2_UART_Frankfurter with hardware UART modem link
2026-08-23 ForEx_2_1: Stabilitaet und korrekte Kurse auf dem Geraet
    Das Geraet lief unzuverlaessig ("laeuft mal, laeuft mal nicht, stuerzt
    manchmal ab"). Ursachen am Board diagnostiziert (ESP8266EX, 4 MB, COM5)
    und behoben:
    1. WiFi war nie abgeschaltet. Im SDK-Konfigbereich des Flash standen
    noch Zugangsdaten aus ForEx_1_1 (0x3FD000/0x3FE000, SSID
    "NECpresenter"). Der SDK versuchte endlos zu verbinden - sichtbar als
    RF-Cal-Block alle ~21 s. Die WiFi-Interrupts zerstoerten das
    Bit-Timing des bit-gebangten SoftwareSerial (19200 Baud, GPIO4/5),
    weshalb AT-Kommandos nur sporadisch durchkamen.
    -> WiFi.persistent(false) + disconnect(true) + mode(WIFI_OFF) +
    forceSleepBegin() am Anfan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
    [ForEx_2_1.ino, X_InternetInfo.ino, x_subroutines.ino]
2026-08-23 ForEx_2_1: SIM-Init kaltstartfest, PIN-Handling entschaerft
    Beim Kaltstart (Netzteil einstecken) meldete das Geraet "SIM nicht
    bereit" und drehte eine Reset-Schleife. Bei allen bisherigen Tests
    wurde nur der ESP8266 ueber DTR resettet - das BK-7670 lief dabei
    durch und war laengst bereit, weshalb das Problem nie auftrat.
    - AT-Handshake: statt 2 Versuchen ueber ~6 s jetzt bis ~30 s geduldig.
    - AT+CPIN? wird nicht mehr genau einmal abgefragt, sondern bis ~25 s
    gepollt. Direkt nach dem Einschalten meldet das Modul je nach
    Zustand noch "SIM PIN" oder "NOT READY", obwohl die Karte kurz
    darauf lesbar ist.
    - PIN-Eingabe war in "#if ACTIVE_PROVIDER == 0" eingeschlossen. Die
    PIN gehoert zur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
    [x_subroutines.ino]
2026-08-23 ForEx_2_1: Kaltstart-Datenverbindung abwarten, Kursabruf nachholen
    Ein echter Kaltstart (Netzstecker) deckte zwei Fehler auf, die bei
    allen bisherigen Tests unsichtbar blieben - dort wurde nur der ESP8266
    ueber DTR resettet, waehrend das BK-7670 durchlief und die
    Datenverbindung laengst stand.
    1. AT+CGACT=1,1 quittiert sofort mit OK, die Datenverbindung ist aber
    noch nicht nutzbar. AT+HTTPINIT antwortete dann mit ERROR und der
    komplette Kursabruf scheiterte. Es wird jetzt ueber AT+CGPADDR=1
    auf eine echte IP-Adresse gewartet (bis 20 s). Kostet kein
    Datenvolumen, da nur der lokale Modulzustand abgefragt wird.
    2. Der Startabruf hatte nur einen einzigen Retry. Schlugen beide fehl,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
    [ForEx_2_1.ino, x_subroutines.ino]
